matthieu-lapeyre/poppy-IO-module/Poppy_IO_Core_v1.1.brd

## EAGLE design Poppy_IO_Core_v1.1.brd (2015-09-27)

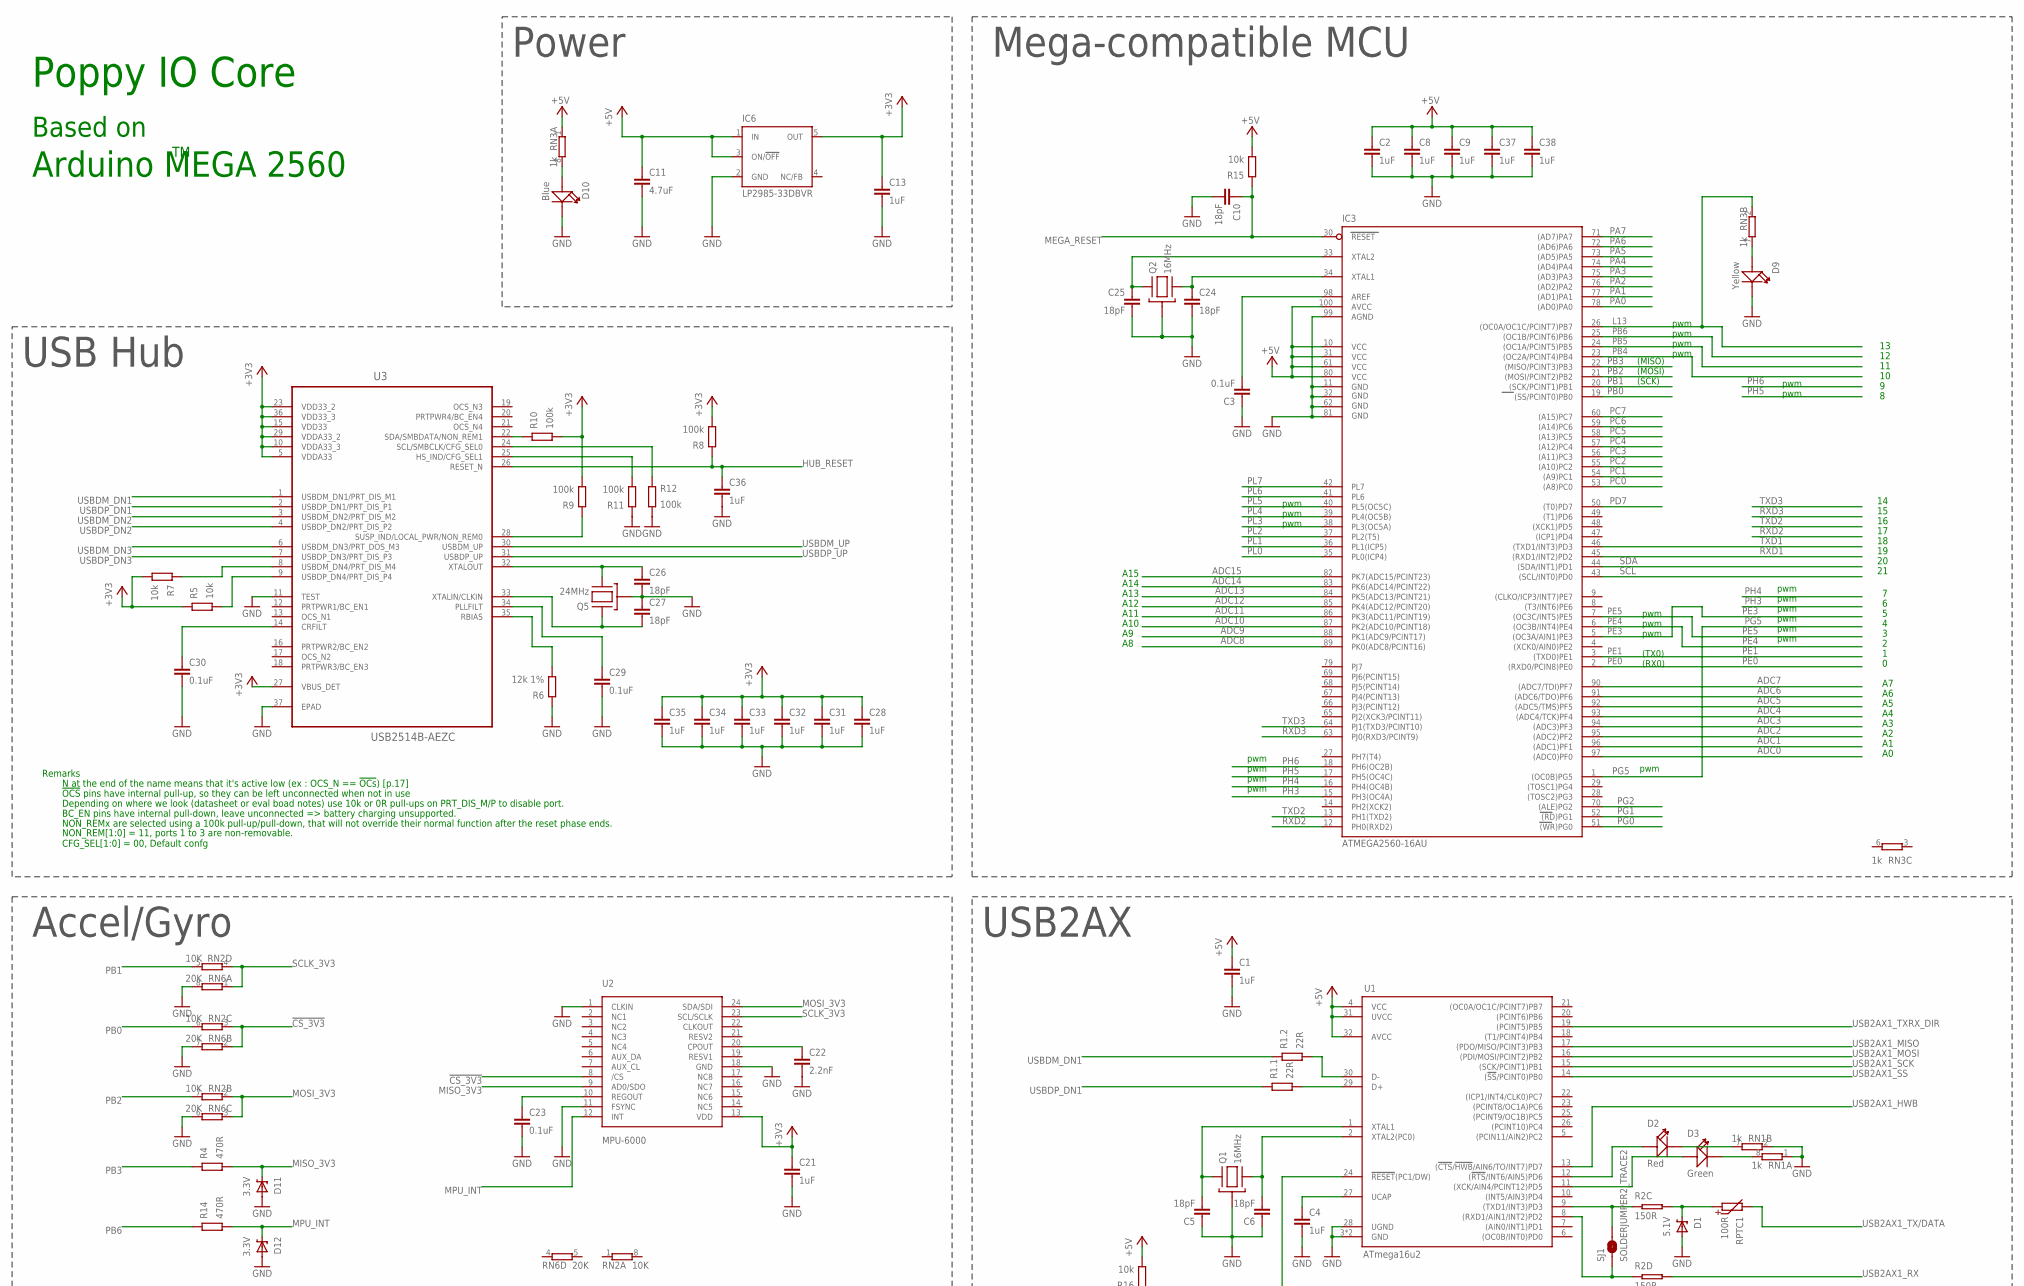
[picture p1: schematic Poppy_IO_Core_v1.1.sch, part in row 1, column 1]

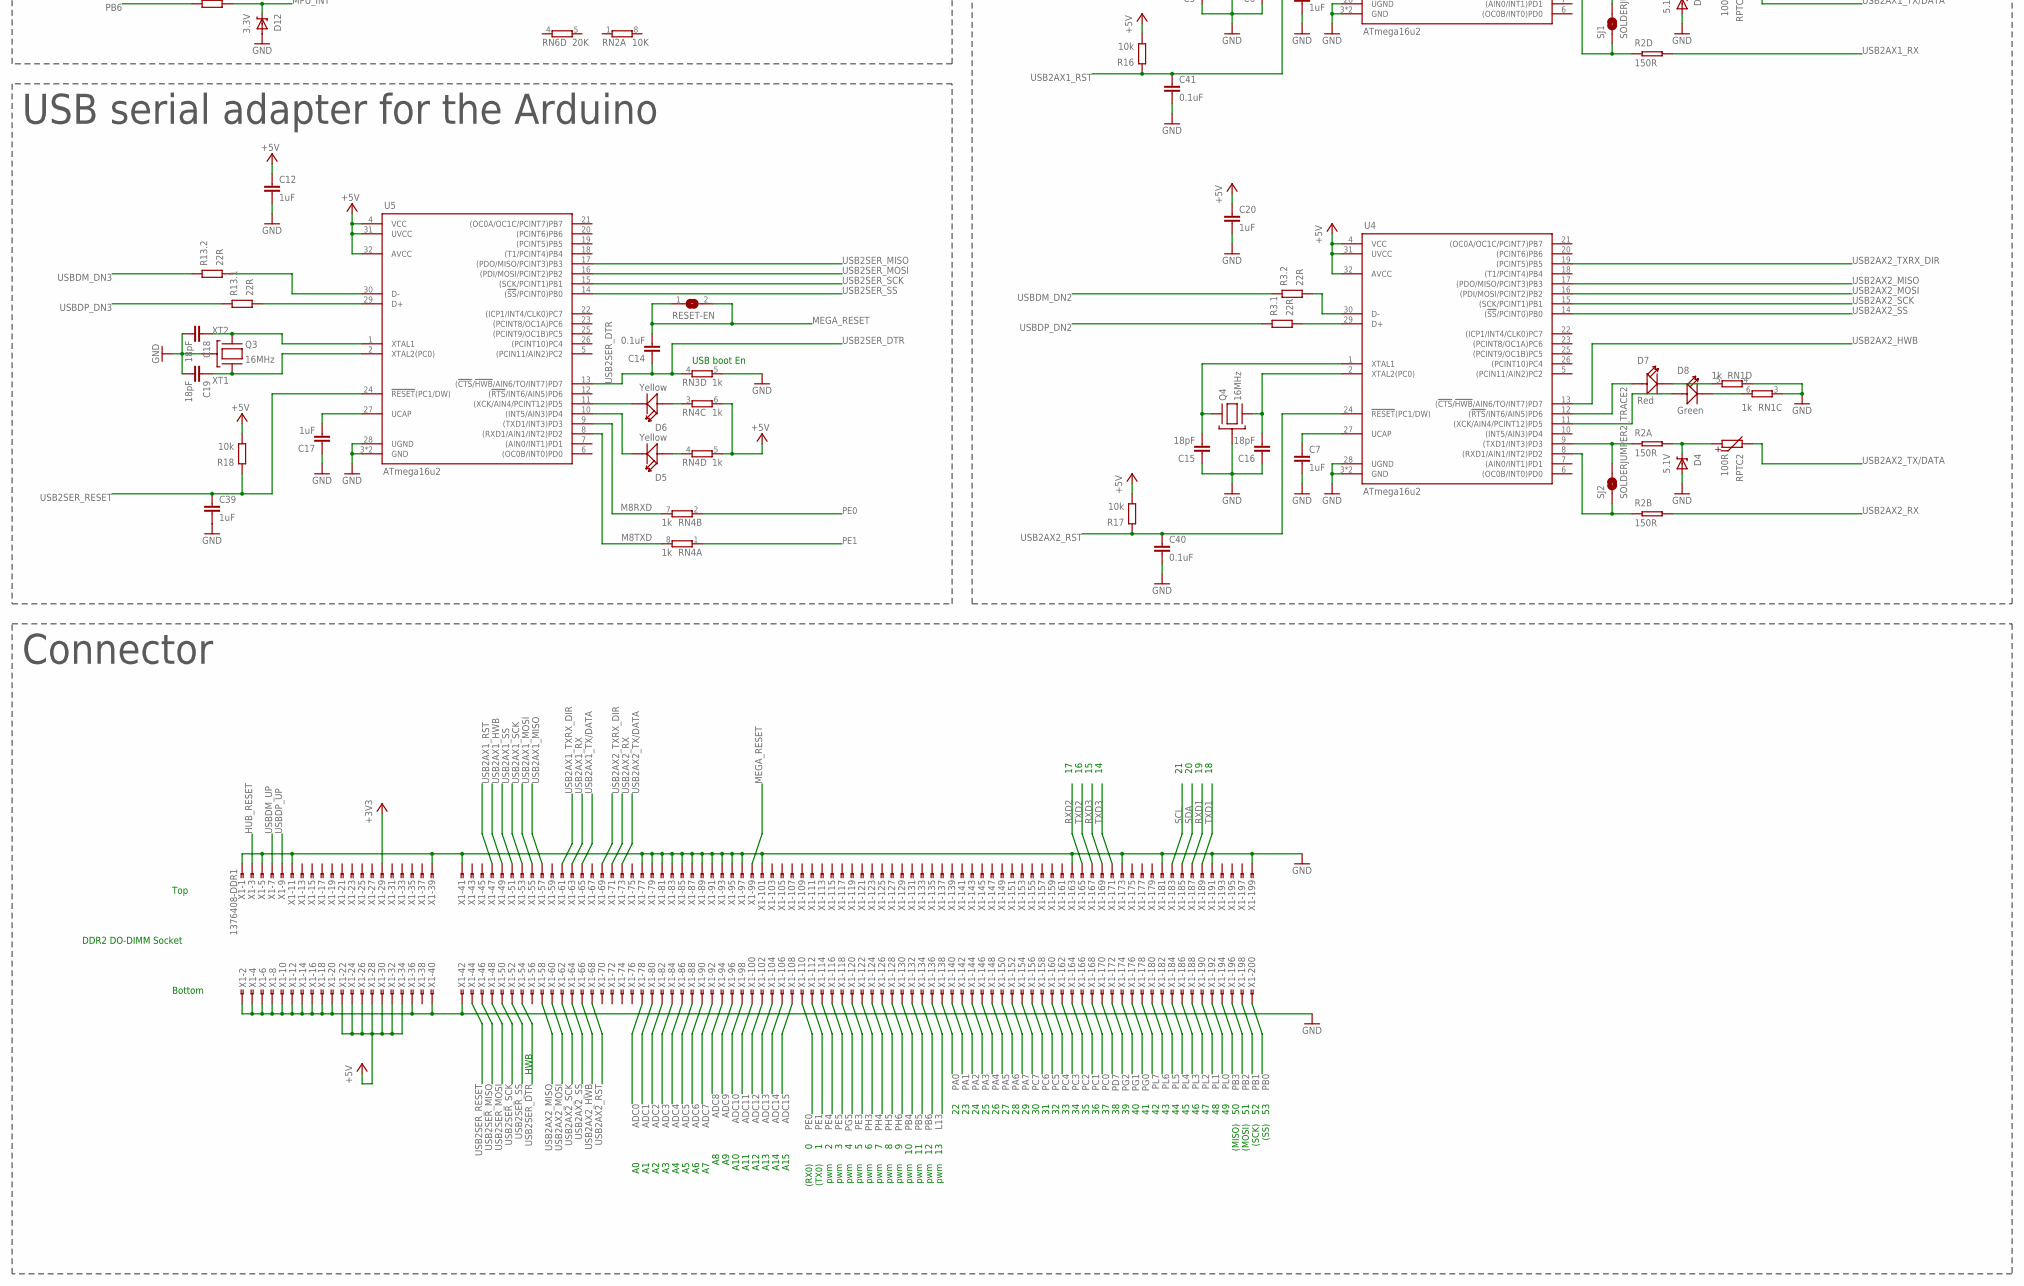
[picture p2: schematic Poppy_IO_Core_v1.1.sch, part in row 2, column 1]

Parts:
C1, C2, C4, C7, C8, C9, C12, C13, C17, C20, C21, C28, C31, C32, C33, C34, C35, C36, C37, C38, C39: 1uF; 0402_N
C3, C14, C23, C29, C30, C40, C41: 0.1uF; 0402_N
C5, C6, C10, C15, C16, C18, C19, C24, C25, C26, C27: 18pF; 0402_N
C11: 4.7uF; 0805_N
C22: 2.2nF; 0402_N
D1, D4: 5.1V; SOD-923_N
D2, D7: Red; LED0603
D3, D8: Green; LED0603
D5, D6, D9: Yellow; LED0603
D10: Blue; LED0603
D11, D12: 3.3V; SOD-523_N
IC3: ATMEGA2560-16AU; TQFP100
IC6: LP2985-33DBVR; SOT23-DBV
Q1, Q2, Q3, Q4: 16MHz; CRYSTAL_MODEL-403_N
Q5: 24MHz; CRYSTAL_MODEL-403_N
R1, R3, R13: 22R; ARRAY_0402_65P_2_N
R2: 150R; R1206-8
R4, R14: 470R; 0402_N
R5, R7, R15, R16, R17, R18: 10k; 0402_N
R6: 12k 1%; 0402_N
R8, R9, R10, R11, R12: 100k; 0402_N
RESET-EN: SJ
RN1, RN3, RN4: 1k; CAY16
RN2: 10K; CAT16
RN6: 20K; CAT16
RPTC1, RPTC2: 100R; 0603_N
SJ1, SJ2: SOLDERJUMPER2_TRACE2; SJ_2S-TRACE2
U1, U4, U5: ATmega16u2; QFN-32_50P_N
U2: MPU-6000; QFN-24
U3: USB2514B-AEZC; QFN50P600X600X100-37N
X1: 1376408-DDR1; DDR1

Connections:
!CS_3V3: RN2.3 (1), RN6.2 (1), U2.8 (/CS)
+3V3: C13.1, C21.1, C28.1, C31.1, C32.1, C33.1, C34.1, C35.1, IC6.5 (OUT), R5.2, R7.1, R8.1, R9.1, R10.1, U2.13 (VDD), U3.5 (VDDA33), U3.10 (VDDA33_3), U3.15 (VDD33), U3.23 (VDD33_2), U3.27 (VBUS_DET), U3.29 (VDDA33_2), U3.36 (VDD33_3), X1.29
+5V: C1.1, C2.1, C8.1, C9.1, C11.1, C12.1, C20.1, C37.1, C38.1, IC3.10 (VCC), IC3.31 (VCC1), IC3.61 (VCC2), IC3.80 (VCC3), IC3.100 (AVCC), IC6.1 (IN), IC6.3 (ON/!OFF), R15.1, R16.1, R17.1, R18.1, RN3.1, RN4.5 (2), RN4.6 (2), U1.4 (VCC), U1.31 (UVCC), U1.32 (AVCC), U4.4 (VCC), U4.31 (UVCC), U4.32 (AVCC), U5.4 (VCC), U5.31 (UVCC), U5.32 (AVCC), X1.22, X1.24, X1.26, X1.28, X1.30, X1.32, X1.34
ADC0: IC3.97 ((ADC0)PF0), X1.78
ADC1: IC3.96 ((ADC1)PF1), X1.80
ADC2: IC3.95 ((ADC2)PF2), X1.82
ADC3: IC3.94 ((ADC3)PF3), X1.84
ADC4: IC3.93 ((ADC4/TCK)PF4), X1.86
ADC5: IC3.92 ((ADC5/TMS)PF5), X1.88
ADC6: IC3.91 ((ADC6/TDO)PF6), X1.90
ADC7: IC3.90 ((ADC7/TDI)PF7), X1.92
ADC8: IC3.89 (PK0(ADC8/PCINT16)), X1.94
ADC9: IC3.88 (PK1(ADC9/PCINT17)), X1.96
ADC10: IC3.87 (PK2(ADC10/PCINT18)), X1.98
ADC11: IC3.86 (PK3(ADC11/PCINT19)), X1.100
ADC12: IC3.85 (PK4(ADC12/PCINT20)), X1.102
ADC13: IC3.84 (PK5(ADC13/PCINT21)), X1.104
ADC14: IC3.83 (PK6(ADC14/PCINT22)), X1.106
ADC15: IC3.82 (PK7(ADC15/PCINT23)), X1.108
AREF: C3.2, IC3.98 (AREF)
GND: C1.2, C2.2, C3.1, C4.2, C5.1, C6.1, C7.2, C8.2, C9.2, C10.2, C11.2, C12.2, C13.2, C15.1, C16.1, C17.1, C18.2, C19.2, C20.2, C21.2, C22.2, C23.2, C24.2, C25.2, C26.2, C27.1, C28.2, C29.2, C30.2, C31.2, C32.2, C33.2, C34.2, C35.2, C36.2, C37.2, C38.2, C39.2, C40.2, C41.2, D1.A, D4.A, D9.-, D10.-, D11.A, D12.A, IC3.11 (GND), IC3.32 (GND1), IC3.62 (GND2), IC3.81 (GND3), IC3.99 (AGND), IC6.2 (GND), Q1.P$2 (GND), Q1.P$4 (GND), Q2.P$2 (GND), Q2.P$4 (GND), Q3.P$2 (GND), Q3.P$4 (GND), Q4.P$2 (GND), Q4.P$4 (GND), Q5.P$2 (GND), Q5.P$4 (GND), R6.2, R11.2, R12.1, RN1.1, RN1.2 (1), RN1.3 (1), RN1.4 (1), RN3.5 (2), RN6.6 (2), RN6.7 (2), RN6.8 (2), U1.3 (GND), U1.28 (UGND), U1.33 (GND), U2.1 (CLKIN), U2.11 (FSYNC), U2.18 (GND), U3.11 (TEST), U3.37 (EPAD), U4.3 (GND), U4.28 (UGND), U4.33 (GND), U5.3 (GND), U5.28 (UGND), U5.33 (GND), X1.1, X1.2, X1.4, X1.5, X1.6, X1.8, X1.10, X1.11, X1.12, X1.14, X1.16, X1.18, X1.20, X1.36, X1.39, X1.40, X1.41, X1.42, X1.77, X1.79, X1.81, X1.83, X1.85, X1.87, X1.89, X1.91, X1.93, X1.95, X1.97, X1.101, X1.163, X1.173, X1.181, X1.191, X1.199
HUB_RESET: C36.1, R8.2, U3.26 (RESET_N), X1.3
L13: IC3.26 ((OC0A/OC1C/PCINT7)PB7), RN3.2 (1), X1.136
M8RXD: RN4.7 (2), U5.9 ((TXD1/INT3)PD3)
M8TXD: RN4.8 (2), U5.8 ((RXD1/AIN1/INT2)PD2)
MEGA_RESET: C10.1, C14.2, IC3.30 (RESET), R15.2, RESET-EN.1, RESET-EN.2, X1.99
MISO_3V3: D11.C, R4.1, U2.9 (AD0/SDO)
MOSI_3V3: RN2.2 (1), RN6.3 (1), U2.24 (SDA/SDI)
MPU_INT: D12.C, R14.1, U2.12 (INT)
unnamed: D8.-, RN1.6 (2)
unnamed: R2.4 (1), SJ1.1, U1.8 ((RXD1/AIN1/INT2)PD2)
unnamed: C4.1, U1.27 (UCAP)
unnamed: D1.C, R2.6 (2), RPTC1.1
unnamed: D3.+, U1.11 ((XCK/AIN4/PCINT12)PD5)
unnamed: D10.+, RN3.8 (2)
unnamed: C6.2, Q1.P$3, U1.2 (XTAL2(PC0))
unnamed: C5.2, Q1.P$1, U1.1 (XTAL1)
unnamed: R1.1, U1.30 (D-)
unnamed: R1.2 (1), U1.29 (D+)
unnamed: D7.-, RN1.5 (2)
unnamed: D2.-, RN1.7 (2)
unnamed: D3.-, RN1.8 (2)
unnamed: R2.1, SJ2.2, U4.9 ((TXD1/INT3)PD3)
unnamed: D2.+, U1.12 ((!RTS!/INT6/AIN5)PD6)
unnamed: D9.+, RN3.7 (2)
unnamed: C7.1, U4.27 (UCAP)
unnamed: C16.2, Q4.P$3, U4.2 (XTAL2(PC0))
unnamed: C15.2, Q4.P$1, U4.1 (XTAL1)
unnamed: R2.3 (1), SJ1.2, U1.9 ((TXD1/INT3)PD3)
unnamed: R2.2 (1), SJ2.1, U4.8 ((RXD1/AIN1/INT2)PD2)
unnamed: D4.C, R2.8 (2), RPTC2.1
unnamed: R3.1, U4.30 (D-)
unnamed: R3.2 (1), U4.29 (D+)
unnamed: D8.+, U4.11 ((XCK/AIN4/PCINT12)PD5)
unnamed: D7.+, U4.12 ((!RTS!/INT6/AIN5)PD6)
unnamed: C23.1, U2.10 (REGOUT)
unnamed: C26.1, Q5.P$3, U3.32 (XTALOUT)
unnamed: C22.1, U2.20 (CPOUT)
unnamed: R7.2, U3.8 (USBDM_DN4/PRT_DIS_M4)
unnamed: C27.2, Q5.P$1, U3.33 (XTALIN/CLKIN)
unnamed: R5.1, U3.9 (USBDP_DN4/PRT_DIS_P4)
unnamed: C30.1, U3.14 (CRFILT)
unnamed: R9.2, U3.28 (SUSP_IND/LOCAL_PWR/NON_REM0)
unnamed: C29.1, U3.34 (PLLFILT)
unnamed: R6.1, U3.35 (RBIAS)
unnamed: R10.2, U3.22 (SDA/SMBDATA/NON_REM1)
unnamed: R12.2, U3.24 (SCL/SMBCLK/CFG_SEL0)
unnamed: R11.1, U3.25 (HS_IND/CFG_SEL1)
unnamed: D5.+, RN4.4 (1)
unnamed: D6.+, RN4.3 (1)
PA0: IC3.78 ((AD0)PA0), X1.138
PA1: IC3.77 ((AD1)PA1), X1.140
PA2: IC3.76 ((AD2)PA2), X1.142
PA3: IC3.75 ((AD3)PA3), X1.144
PA4: IC3.74 ((AD4)PA4), X1.146
PA5: IC3.73 ((AD5)PA5), X1.148
PA6: IC3.72 ((AD6)PA6), X1.150
PA7: IC3.71 ((AD7)PA7), X1.152
PB0: IC3.19 ((SS/PCINT0)PB0), RN2.6 (2), X1.200
PB1: IC3.20 ((SCK/PCINT1)PB1), RN2.5 (2), X1.198
PB2: IC3.21 ((MOSI/PCINT2)PB2), RN2.7 (2), X1.196
PB3: IC3.22 ((MISO/PCINT3)PB3), R4.2, X1.194
PB4: IC3.23 ((OC2A/PCINT4)PB4), X1.130
PB5: IC3.24 ((OC1A/PCINT5)PB5), X1.132
PB6: IC3.25 ((OC1B/PCINT6)PB6), R14.2, X1.134
PC0: IC3.53 ((A8)PC0), X1.168
PC1: IC3.54 ((A9)PC1), X1.166
PC2: IC3.55 ((A10)PC2), X1.164
PC3: IC3.56 ((A11)PC3), X1.162
PC4: IC3.57 ((A12)PC4), X1.160
PC5: IC3.58 ((A13)PC5), X1.158
PC6: IC3.59 ((A14)PC6), X1.156
PC7: IC3.60 ((A15)PC7), X1.154
PD7: IC3.50 ((T0)PD7), X1.170
PE0: IC3.2 ((RXD0/PCIN8)PE0), RN4.2 (1), X1.110
PE1: IC3.3 ((TXD0)PE1), RN4.1, X1.112
PE3: IC3.5 ((OC3A/AIN1)PE3), X1.120
PE4: IC3.6 ((OC3B/INT4)PE4), X1.114
PE5: IC3.7 ((OC3C/INT5)PE5), X1.116
PG0: IC3.51 ((WR)PG0), X1.176
PG1: IC3.52 ((RD)PG1), X1.174
PG2: IC3.70 ((ALE)PG2), X1.172
PG5: IC3.1 ((OC0B)PG5), X1.118
PH3: IC3.15 (PH3(OC4A)), X1.122
PH4: IC3.16 (PH4(OC4B)), X1.124
PH5: IC3.17 (PH5(OC4C)), X1.126
PH6: IC3.18 (PH6(OC2B)), X1.128
PL0: IC3.35 (PL0(ICP4)), X1.192
PL1: IC3.36 (PL1(ICP5)), X1.190
PL2: IC3.37 (PL2(T5)), X1.188
PL3: IC3.38 (PL3(OC5A)), X1.186
PL4: IC3.39 (PL4(OC5B)), X1.184
PL5: IC3.40 (PL5(OC5C)), X1.182
PL6: IC3.41 (PL6), X1.180
PL7: IC3.42 (PL7), X1.178
RD+: R13.2 (1), U5.29 (D+)
RD-: R13.1, U5.30 (D-)
RXD1: IC3.45 ((RXD1/INT2)PD2), X1.187
RXD2: IC3.12 (PH0(RXD2)), X1.165
RXD3: IC3.63 (PJ0(RXD3/PCINT9)), X1.169
RXL: D5.-, U5.10 ((INT5/AIN3)PD4)
SCL: IC3.43 ((SCL/INT0)PD0), X1.183
SCLK_3V3: RN2.4 (1), RN6.1, U2.23 (SCL/SCLK)
SDA: IC3.44 ((SDA/INT1)PD1), X1.185
TXD1: IC3.46 ((TXD1/INT3)PD3), X1.189
TXD2: IC3.13 (PH1(TXD2)), X1.167
TXD3: IC3.64 (PJ1(TXD3/PCINT10)), X1.171
TXL: D6.-, U5.11 ((XCK/AIN4/PCINT12)PD5)
USB2AX1_HWB: U1.13 ((!CTS!/!HWB!/AIN6/TO/INT7)PD7), X1.49
USB2AX1_MISO: U1.17 ((PDO/MISO/PCINT3)PB3), X1.57
USB2AX1_MOSI: U1.16 ((PDI/MOSI/PCINT2)PB2), X1.55
USB2AX1_RST: C41.1, R16.2, U1.24 (!RESET!(PC1/DW)), X1.47
USB2AX1_RX: R2.5 (2), X1.63
USB2AX1_SCK: U1.15 ((SCK/PCINT1)PB1), X1.53
USB2AX1_SS: U1.14 ((!SS!/PCINT0)PB0), X1.51
USB2AX1_TX/DATA: RPTC1.2, X1.65
USB2AX1_TXRX_DIR: U1.19 ((PCINT5)PB5), X1.61
USB2AX2_HWB: U4.13 ((!CTS!/!HWB!/AIN6/TO/INT7)PD7), X1.66
USB2AX2_MISO: U4.17 ((PDO/MISO/PCINT3)PB3), X1.58
USB2AX2_MOSI: U4.16 ((PDI/MOSI/PCINT2)PB2), X1.60
USB2AX2_RST: C40.1, R17.2, U4.24 (!RESET!(PC1/DW)), X1.68
USB2AX2_RX: R2.7 (2), X1.71
USB2AX2_SCK: U4.15 ((SCK/PCINT1)PB1), X1.62
USB2AX2_SS: U4.14 ((!SS!/PCINT0)PB0), X1.64
USB2AX2_TX/DATA: RPTC2.2, X1.73
USB2AX2_TXRX_DIR: U4.19 ((PCINT5)PB5), X1.69
USB2SER_DTR: C14.1, RN3.4 (1), U5.13 ((!CTS!/!HWB!/AIN6/TO/INT7)PD7), X1.54
USB2SER_MISO: U5.17 ((PDO/MISO/PCINT3)PB3), X1.46
USB2SER_MOSI: U5.16 ((PDI/MOSI/PCINT2)PB2), X1.48
USB2SER_RESET: C39.1, R18.2, U5.24 (!RESET!(PC1/DW)), X1.44
USB2SER_SCK: U5.15 ((SCK/PCINT1)PB1), X1.50
USB2SER_SS: U5.14 ((!SS!/PCINT0)PB0), X1.52
USBDM_DN1: R1.4 (2), U3.1 (USBDM_DN1/PRT_DIS_M1)
USBDM_DN2: R3.4 (2), U3.3 (USBDM_DN2/PRT_DIS_M2)
USBDM_DN3: R13.4 (2), U3.6 (USBDM_DN3/PRT_DOS_M3)
USBDM_UP: U3.30 (USBDM_UP), X1.7
USBDP_DN1: R1.3 (2), U3.2 (USBDP_DN1/PRT_DIS_P1)
USBDP_DN2: R3.3 (2), U3.4 (USBDP_DN2/PRT_DIS_P2)
USBDP_DN3: R13.3 (2), U3.7 (USBDP_DN3/PRT_DIS_P3)
USBDP_UP: U3.31 (USBDP_UP), X1.9
VUCAP: C17.2, U5.27 (UCAP)
XT1: C19.1, Q3.P$3, U5.2 (XTAL2(PC0))
XT2: C18.1, Q3.P$1, U5.1 (XTAL1)
XTAL1: C24.1, IC3.34 (XTAL1), Q2.P$3
XTAL2: C25.1, IC3.33 (XTAL2), Q2.P$1

Notes on the sheet:
Top
Bottom
DDR2 DO-DIMM Socket
Arduino MEGA 2560
pwm
(TX0)
(RX0)
(MISO)
(SCK)
(MOSI)
(SS)
USB boot En
Based on
Accel/Gyro
Depending on where we look (datasheet or eval boad notes) use 10k or 0R pull-ups on PRT_DIS_M/P to disable port.
NON_REM[1:0] = 11, ports 1 to 3 are non-removable. CFG_SEL[1:0] = 00, Default confg
!OCS! pins have internal pull-up, so they can be left unconnected when not in use
N at the end of the name means that it's active low (ex : OCS_N == !OCs!) [p.17]
Remarks
BC_EN pins have internal pull-down, leave unconnected => battery charging unsupported.
NON_REMx are selected using a 100k pull-up/pull-down, that will not override their normal function after the reset phase ends.
USB Hub
USB2AX
Power
Connector
USB serial adapter for the Arduino
Poppy IO Core
A10
A11
A12
A13
A14
A15
Mega-compatible MCU
HWB

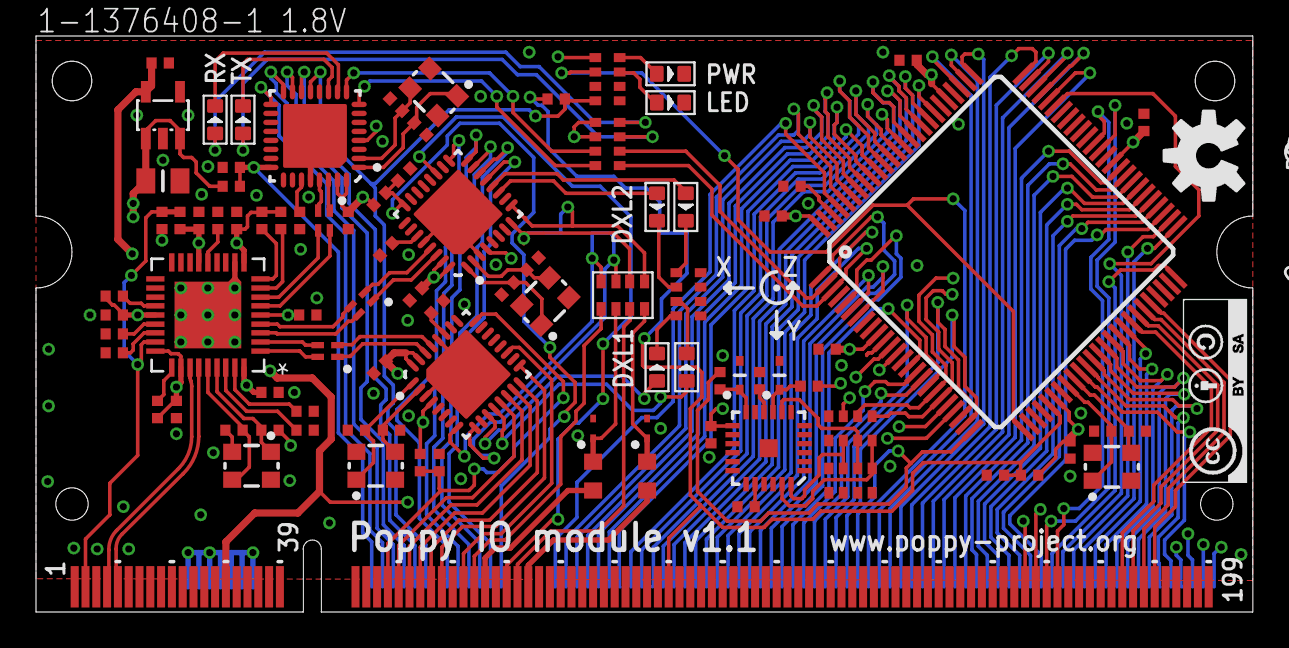
[picture p3: board Poppy_IO_Core_v1.1.brd from above]

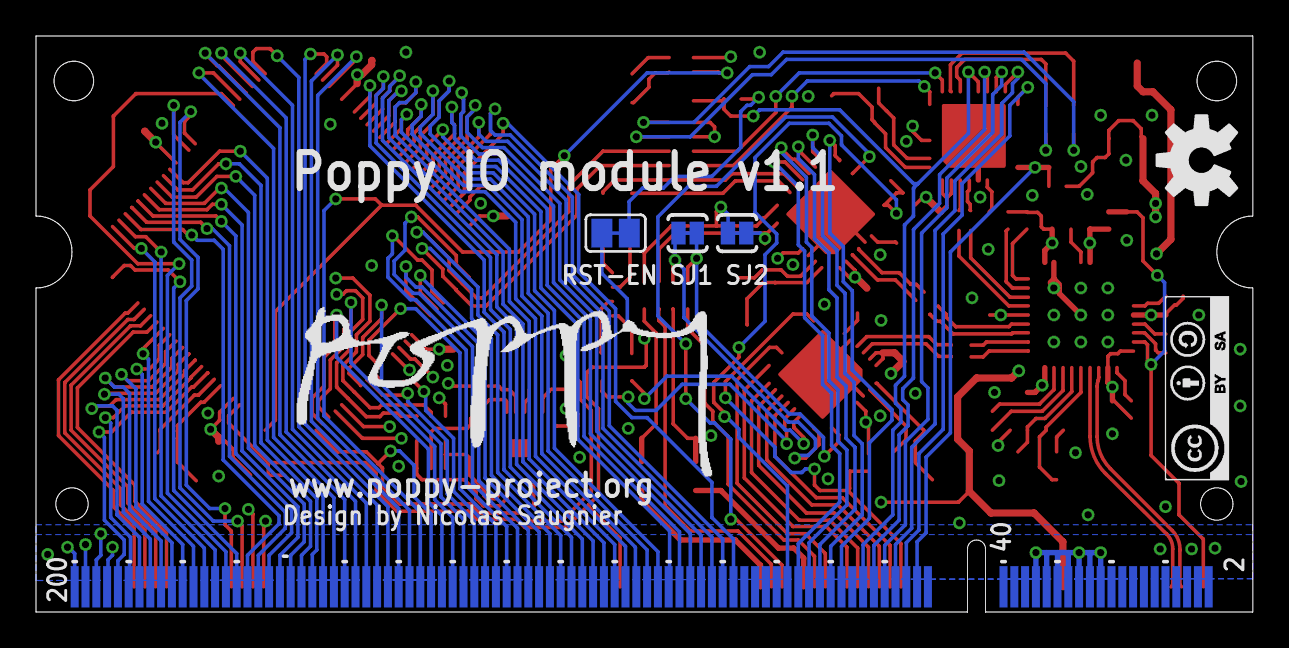
[picture p4: board Poppy_IO_Core_v1.1.brd from below]

Board: 4 copper layers, 67.6 x 32.0 mm, 98 parts (5 on the bottom side), 165 nets.

Other parts of the board:
U$1, U$3: OSHW-LOGO-M
U$2, U$4: CC-BY-SA
