matthieu-lapeyre/poppy-IO-module/(commit log)

2014-08-29 Added initial files. Schematics and routing are done, cosmetic changes are still needed.
    [Poppy_IO_Core_v1.0.brd, Poppy_IO_Core_v1.0.sch]
2014-08-29 Connected some (important) signals that had been omitted.
    [Poppy_IO_Core_v1.0.brd, Poppy_IO_Core_v1.0.sch]
2014-08-29 Aesthetics of the board done (text / logos)
    [Poppy_IO_Core_v1.0.brd, Poppy_IO_Core_v1.0.sch]
2014-08-30 Replaced 3.3V SOD-923 LEDs with ones easier to source.
    [Poppy_IO_Core_v1.0.brd, Poppy_IO_Core_v1.0.sch]
2014-08-31 Corrected a problem with paste layer (paste on the gold contacts would have made for a poor result...).
    [Poppy_IO_Core_v1.0.brd, Poppy_IO_Core_v1.0.sch]
2014-08-31 Adjusted visible layers
    [Poppy_IO_Core_v1.0.brd]
2014-09-11 Some cosmetic adjustment so that it looks as supposed in circuithub: - removed names and values from the board to hide them (no way to hide the layer!) - removed all solder paste on the back
    [Poppy_IO_Core_v1.0.brd, Poppy_IO_Core_v1.0.sch]
2015-09-27 Addede v1.1 : changed footprint to DDR1
    [Poppy_IO_Core_v1.1.brd, Poppy_IO_Core_v1.1.sch]
2015-11-19 remove old version
    [Poppy_IO_Core_v1.0.brd, Poppy_IO_Core_v1.0.sch]
